marcelovani/arduino-obd2-turbo/sketches/turbo/Settings.h

// Settings.h — Runtime-adjustable parameters and NVS persistence.
//
// cfg* variables are the live trigger/audio values used throughout the sketch.
// CFG_DEFS[] maps each variable to its menu label, edit step, and limits.
// Changes take effect immediately when edited in the menu.
// Saved to NVS on "< Back"; wiped and restored to defaults on "Factory Reset".

enum SettingType { SETTING_FLOAT, SETTING_INT, SETTING_BOOL };

struct SettingDef {
  const char*  label;
  float*       val;
  float        step;  // for BOOL: the "On" threshold value; for others: edit increment
  float        vmin;
  float        vmax;
  SettingType  type;
};

// Initialised from compile-time defaults; changed at runtime via the Settings menu.
float cfgThrottleHigh = TURBO_THROTTLE_HIGH;
float cfgThrottleLow  = TURBO_THROTTLE_LOW;
float cfgRpmMin       = TURBO_RPM_MIN;
float cfgMinGear      = (float)TURBO_MIN_GEAR;
float cfgMaxGear      = (float)TURBO_MAX_GEAR;
float cfgCooldownMs   = (float)TURBO_COOLDOWN_MS;
float cfgVolGear1     = (float)TURBO_VOLUME_GEAR1;
float cfgVolGear2     = (float)TURBO_VOLUME_GEAR2;
float cfgSpeed12      = TURBO_SPEED_GEAR12;
float cfgSpeed23      = TURBO_SPEED_GEAR23;
float cfgVolVoice     = (float)TURBO_VOLUME_VOICE;
float cfgRpmRiseMax   = TURBO_RPM_RISE_MAX;

static SettingDef CFG_DEFS[] = {
  // Turbo trigger conditions (all must be true simultaneously):
  {"Throttle Hi%", &cfgThrottleHigh,   5.0f,  10.0f, 100.0f, SETTING_FLOAT}, // TPS must have been above this (hard push)
  {"Throttle Lo%", &cfgThrottleLow,    1.0f,   0.0f,  50.0f, SETTING_FLOAT}, // TPS must now be below this (lifted off)
  {"RPM Min",      &cfgRpmMin,       100.0f, 500.0f, 6000.0f, SETTING_INT  }, // engine must be spinning above this RPM
  {"Min Gear",     &cfgMinGear,        1.0f,   1.0f,    6.0f, SETTING_INT  }, // only trigger in this gear or higher
  {"Max Gear",     &cfgMaxGear,        1.0f,   1.0f,    6.0f, SETTING_INT  }, // only trigger in this gear or lower
  {"Cooldown ms",  &cfgCooldownMs,   100.0f, 500.0f,10000.0f, SETTING_INT  }, // min time between two triggers (ms)
  // Audio volumes (DFPlayer scale 0–30):
  {"Vol Gear 1",   &cfgVolGear1,       1.0f,   1.0f,   30.0f, SETTING_INT  }, // spray volume for 1st gear change
  {"Vol Gear 2",   &cfgVolGear2,       1.0f,   1.0f,   30.0f, SETTING_INT  }, // spray volume for 2nd gear change
  {"Vol Voice",    &cfgVolVoice,       1.0f,   1.0f,   30.0f, SETTING_INT  }, // voice announcements volume
  // Gear estimation speed bands (km/h — OBD2 PID 010D is always km/h):
  {"Spd G1/G2 km", &cfgSpeed12,        5.0f,   0.0f,  100.0f, SETTING_INT  }, // speed below this = 1st gear
  {"Spd G2/G3 km", &cfgSpeed23,        5.0f,   0.0f,  150.0f, SETTING_INT  }, // speed below this (and ≥ G1/G2) = 2nd gear
  // Free-rev guard — suppresses trigger when RPM jumps fast (clutch in, no load):
  {"Rev Guard",    &cfgRpmRiseMax,   500.0f,   0.0f, 2000.0f, SETTING_BOOL }, // On = 500 RPM/poll threshold; Off = 0
};
#define NUM_CFG_DEFS  (int)(sizeof(CFG_DEFS) / sizeof(CFG_DEFS[0]))

// ── NVS persistence (real device and DEMO builds only) ────────────────────
#ifndef SIMULATION
static void loadSettings() {
  Preferences prefs;
  prefs.begin("turbo", true);
  cfgThrottleHigh = prefs.getFloat("tpsHigh",  cfgThrottleHigh);
  cfgThrottleLow  = prefs.getFloat("tpsLow",   cfgThrottleLow);
  cfgRpmMin       = prefs.getFloat("rpmMin",   cfgRpmMin);
  cfgMinGear      = prefs.getFloat("minGear",  cfgMinGear);
  cfgMaxGear      = prefs.getFloat("maxGear",  cfgMaxGear);
  cfgCooldownMs   = prefs.getFloat("cooldown", cfgCooldownMs);
  cfgVolGear1     = prefs.getFloat("volG1",    cfgVolGear1);
  cfgVolGear2     = prefs.getFloat("volG2",    cfgVolGear2);
  cfgSpeed12      = prefs.getFloat("spd12",    cfgSpeed12);
  cfgSpeed23      = prefs.getFloat("spd23",    cfgSpeed23);
  cfgVolVoice     = prefs.getFloat("volVoice", cfgVolVoice);
  cfgRpmRiseMax   = prefs.getFloat("rpmRise",  cfgRpmRiseMax);
  prefs.end();
}

static void saveSettings() {
  Preferences prefs;
  prefs.begin("turbo", false);
  prefs.putFloat("tpsHigh",  cfgThrottleHigh);
  prefs.putFloat("tpsLow",   cfgThrottleLow);
  prefs.putFloat("rpmMin",   cfgRpmMin);
  prefs.putFloat("minGear",  cfgMinGear);
  prefs.putFloat("maxGear",  cfgMaxGear);
  prefs.putFloat("cooldown", cfgCooldownMs);
  prefs.putFloat("volG1",    cfgVolGear1);
  prefs.putFloat("volG2",    cfgVolGear2);
  prefs.putFloat("spd12",    cfgSpeed12);
  prefs.putFloat("spd23",    cfgSpeed23);
  prefs.putFloat("volVoice", cfgVolVoice);
  prefs.putFloat("rpmRise",  cfgRpmRiseMax);
  prefs.end();
}

static void resetSettings() {
  Preferences prefs;
  prefs.begin("turbo", false);
  prefs.clear();   // wipe the entire "turbo" NVS namespace
  prefs.end();
  cfgThrottleHigh = TURBO_THROTTLE_HIGH;
  cfgThrottleLow  = TURBO_THROTTLE_LOW;
  cfgRpmMin       = TURBO_RPM_MIN;
  cfgMinGear      = (float)TURBO_MIN_GEAR;
  cfgMaxGear      = (float)TURBO_MAX_GEAR;
  cfgCooldownMs   = (float)TURBO_COOLDOWN_MS;
  cfgVolGear1     = (float)TURBO_VOLUME_GEAR1;
  cfgVolGear2     = (float)TURBO_VOLUME_GEAR2;
  cfgSpeed12      = TURBO_SPEED_GEAR12;
  cfgSpeed23      = TURBO_SPEED_GEAR23;
  cfgVolVoice     = (float)TURBO_VOLUME_VOICE;
  cfgRpmRiseMax   = TURBO_RPM_RISE_MAX;
}
#endif
