marcelovani/arduino-obd2-turbo/(commit log)

2026-05-12 Add project plan, README, and CLAUDE.md
    Initial commit for the OBD2 turbo blow-off valve emulator project.
    Covers hardware decisions, BOV trigger algorithm, wiring, build phases,
    and all references from the planning session.
2026-05-12 Update plan with manual gearbox, speaker, and BT audio upgrade
    - CLA180 confirmed manual gearbox; BOV trigger via throttle-drop (no clutch PID needed)
    - Speaker uses DFPlayer Mini built-in 3W amp
    - microSD confirmed available
    - Added Bluetooth A2DP car radio as Phase 6 upgrade option
2026-05-12 Add phase sketches and testing guide
    Phase 1: hardware verification (OLED, IMU, encoder, DFPlayer)
    Phase 2: OBD2 Bluetooth auto-connect + live data
    Phase 3: BOV trigger — plays sound on throttle drop in gears 1-2
    Phase 4: full dashboard — state machine, all sensors, encoder nav
    Each sketch is standalone and buildable independently.
    TESTING.md documents wiring, deploy steps, and expected results per phase.
2026-05-12 Fix Bluetooth PIN, add connection feedback, add no-engine parameters
    - All BT connection code now tries PIN 1234 then 0000 automatically
    - OLED shows which PIN is being tried during connection
    - Connected state shown as filled dot in top-right corner of every screen
    - Phase 2 now reads battery voltage (ATRV), fuel level (012F), and
    coolant temp (0105) — all readable with ignition on, engine off
    - TESTING.md documents all three improvements with troubleshooting tips
2026-05-12 Add test suite, visual monitor, and Makefile
    Unit tests (39 passing):
    - TestParsePid: 13 tests covering speed, RPM, throttle, edge cases
    - TestEstimateGear: 8 tests covering all gears and stopped state
    - TestBovTrigger: 10 tests covering all trigger conditions and cooldown
    - TestScenarios: 7 scenario replays asserting correct BOV counts
    Integration tests:
    - MockElm327Server: in-process TCP ELM327 server with dynamic PID values
    - ElmClient: TCP client matching the ESP32 BluetoothSerial API
    - Tests covering AT init sequence, all PID polling, and end-to-end BOV trigger
    Visual monitor:
    - Terminal OLED simulation with rich library
    - Real-time scenario playback with throttle ba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
2026-05-12 Add Wokwi simulation files (diagram + sketch + libraries)
    Wokwi project in Emulators/Wokwi/ that runs the BOV emulator logic
    in a browser-based circuit simulation without real hardware:
    - diagram.json: ESP32 + SSD1306 OLED + MPU6050 + KY-040 encoder +
    buzzer (DFPlayer placeholder via 1kΩ resistor on GPIO17)
    - sketch.ino: replays a built-in 9s driving scenario that fires two BOV
    triggers (1st→2nd at 2800ms, 2nd→3rd at 5000ms), shows live gauges
    on the simulated OLED, reads real G-force from the MPU6050, and
    lets the encoder cycle views / reset counter
    - libraries.txt: U8g2, Bounce2, Adafruit MPU6050, Adafruit Unified Sensor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
    [sketch.ino]
2026-05-12 Fix Wokwi diagram GND pin names (GND.1/GND.2 → GND)
    wokwi-esp32-devkit-v1 uses esp:GND (not esp:GND.1 / esp:GND.2),
    so the connections were silently ignored and the ESP32 appeared
    unconnected on the canvas.
2026-05-12 Rearrange Wokwi diagram: correct pin names + component positions
    Three fixes combined:
    - Restore GND.1 / GND.2 (correct board.json pin names — my earlier
    change to plain "GND" was wrong and silently dropped all ground wires)
    - Use TX2 instead of D17 (correct board.json name for GPIO17)
    - Reposition components near the pins they connect to:
    OLED + MPU6050 → left of ESP32 (D21/D22 are on left header)
    KY-040 → right of ESP32 (D25/D26/D27 are on right header)
    Buzzer + resistor → left of ESP32 near TX2/D17 level
    Resistor is now horizontal (chain: TX2 → r1:2 → r1:1 → buz:1)
2026-05-12 Add wokwi.toml for VS Code extension
    Points to the Arduino CLI default build output path for the ESP32
    DOIT DevKit V1 board. Compile first with:
    arduino-cli compile --fqbn esp32:esp32:esp32doit-devkit-v1 Emulators/Wokwi/
2026-05-12 Add wokwi-build Makefile target and fix firmware path
    - wokwi-setup: installs arduino-cli board package + libraries (run once)
    - wokwi-build: compiles Emulators/Wokwi/sketch.ino → build/sketch.ino.bin
    - wokwi.toml: firmware path now relative to workspace root, matching
    the arduino-cli --output-dir output
    - .gitignore: exclude Emulators/Wokwi/build/ (compiled artifacts)
    Usage:
    brew install arduino-cli
    make wokwi-setup
    make wokwi-build
2026-05-12 Rename BOV to Turbo; replace Wokwi buzzer with LED indicator
    - Rename all BOV_* constants, bov* variables, checkBov() → Turbo throughout
    all sketches, Python tests, scenarios, and documentation
    - Replace wokwi-buzzer with wokwi-led in diagram.json; LED blinks at ~5 Hz
    for 1 s on each Turbo trigger
    - Add OLED filled-circle indicator (top-right) that mirrors the LED state
    - Rename sketch.ino → Wokwi.ino (arduino-cli requires filename = folder name)
    - Fix wokwi.toml firmware paths to match new binary name
2026-05-12 Remove MPU6050 accelerometer from project
    Not used in trigger logic; removed from Wokwi sketch, diagram, libraries.txt,
    phase4 dashboard, Makefile wokwi-setup, and README hardware table.
2026-05-12 Consolidate into single sketch: sketches/turbo/turbo.ino
    Replace all phase sketches and the separate Wokwi.ino with one unified
    turbo.ino. Simulation vs real-device code is split with #ifdef SIMULATION;
    Makefile passes -DSIMULATION when building for Wokwi. All display logic,
    encoder zone-tracking, and Turbo trigger live in one place.
    - Add sketches/turbo/turbo.ino (unified sketch)
    - Remove Emulators/Wokwi/Wokwi.ino (superseded)
    - Remove sketches/phase1_*, phase2_*, phase3_*, phase4_* (development artefacts)
    - Update Makefile: SKETCH=sketches/turbo, wokwi-build adds -DSIMULATION
    - Update Emulators/Wokwi/wokwi.toml: firmware path → turbo.ino.bin
    - Update README, TESTING.md, CLAUDE.md, tests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
    [turbo.ino]
2026-05-12 Ignore sketches/turbo/build/ arduino-cli output
2026-05-12 Add startup UX and parked screen for real device
    - SCANNING: animated spinner + "Plug ELM327 into OBD2 port" hint
    - CONNECTING: shows device name found before attempting connection
    - INIT_ELM: reads battery voltage immediately after ELM327 init,
    shows "OBD2 connected!" + voltage on confirmation screen
    - RUNNING (engine off, RPM < 200): slow-polls voltage + coolant temp
    every 3s and shows parked screen with blinking "Start engine..."
    - RUNNING (engine on, RPM >= 200): fast-polls TPS/speed/RPM at 10Hz
    and shows the normal gauge views as before
2026-05-12 Simulate all startup stages in Wokwi
    The simulation now mirrors the real device flow:
    SIM_SCANNING (3s) — animated spinner, "Looking for ELM327"
    SIM_CONNECTING (2s) — "Found: ELM327-SIM / Connecting..."
    SIM_INIT (3s) — "Initialising..." then "OBD2 connected!" + battery 12.4V
    SIM_RUNNING — scenario playback
    Scenario extended with 2s engine-off at the start so the parked screen
    (battery + coolant, blinking "Start engine...") is shown before the driving
    begins. drawParked() and showMessage() moved to shared code so both builds
    use the same display logic.
2026-05-12 Play Turbo sound at gear-dependent volume
    Gear 1: volume 30 (100%), gear 2: volume 21 (70%).
    DFPlayer volume is set immediately before play() on each trigger.
2026-05-13 Fix parked-screen flicker during driving
    When an OBD2 poll timed out, parsePID returned -1 and max(0, -1)
    silently set metricRPM=0, triggering the parked screen for one frame.
    Fixed by only updating each metric when the parse result is valid (>=0),
    keeping the last good value on a failed read.
    Also removed duplicate String declaration left by earlier edit.
    [turbo.ino]
2026-05-13 Fix parked screen appearing during driving (two cases)
    Simulation: scenario loop was restarting at index 0 (RPM=0), showing the
    parked screen for 2s on every 11s loop. Now restarts at index 1 (engine
    already at idle, RPM=800) so the loop is seamless.
    Real device: added 3s debounce on the engine-off transition so a transient
    RPM drop (bad poll, brief idle dip) does not immediately flip to the parked
    screen — RPM must stay below ENGINE_IDLE_RPM for 3 consecutive seconds.
    [turbo.ino]
2026-05-13 Fix unresponsive rotary encoder on real device
    Root cause: each obdSend() blocks for up to 1s; the KY-040 CLK pulse
    lasts only ~2ms, so the main loop misses almost every rotation.
    Fix: attach a FALLING-edge interrupt (encISR, IRAM_ATTR) to PIN_ENC_CLK
    so every click is captured immediately into a volatile counter (encDelta).
    readEncoder() atomically drains that counter with noInterrupts/interrupts
    guard each time it runs.
    Also drop STEPS_PER_ZONE from 5 to 1 (1 click = 1 view change) since
    with ISR capture all detents are counted reliably.
    Simulation keeps the original CLK polling (no blocking calls there).
    [turbo.ino]
2026-05-13 Fix encoder ISR debounce (KY-040 contact bounce)
    Previous ISR fired on every bounce pulse; with STEPS_PER_ZONE=1 and
    4 views, bounce accumulating +1/-1 noise often netted to 0 or a multiple
    of 4, making the encoder appear dead.
    Fixes:
    - 4ms debounce in ISR: rejects contact bounce (KY-040 bounce < 3ms)
    - GPIO.in register read instead of digitalRead() — faster and safe in ISR
    - micros() timestamp guards rapid re-entry
    [turbo.ino]
2026-05-13 Fix CCW encoder direction not working
    Root causes:
    1. Single shared 4ms debounce blocked CCW clicks arriving <4ms after a CW
    2. Some KY-040 variants lead with DT not CLK for CCW, so FALLING-CLK ISR
    never fires for CCW at all
    Fix: two independent ISRs with separate 1ms debounce timers:
    encISR_CLK — CLK FALLING while DT=HIGH → one direction (encDelta--)
    encISR_DT — DT FALLING while CLK=HIGH → other direction (encDelta++)
    Both pins attached in setup(). Covers all KY-040 variants, and CW/CCW
    in rapid succession no longer block each other.
    [turbo.ino]
2026-05-13 Fix encoder CCW direction: timing-based ISR replaces pin-state check
    Previous approach read GPIO state inside the ISR to determine direction,
    but on this KY-040 variant both pins change simultaneously for CCW so
    the state check always read the wrong level.
    New approach: whichever pin falls first updates its own timestamp and
    checks whether the other pin's timestamp is stale (>500 µs ago). The
    trailing pin's ISR then skips because it sees a recent cross-pin
    timestamp. This correctly identifies direction without reading pin
    state, and 500 µs self-debounce handles contact bounce.
    [turbo.ino]
2026-05-13 Reduce encoder/display lag: refresh between OBD2 calls, lower timeout
    Each obdSend() was blocking up to 1000ms; 3 calls per poll = up to 3s
    where the encoder and display could not update. Fix: call readEncoder()
    + drawDisplay() between each OBD2 query so the screen stays responsive
    during a poll. Also drop the default obdSend() timeout from 1000ms to
    300ms — on a healthy CAN/BT connection responses arrive in <150ms, and
    the old 1s timeout was the worst-case source of lag.
    [turbo.ino]
2026-05-13 Give encoder priority over OBD2 polling
    When the encoder is turned, OBD2 polling is suspended for 500ms so the
    main loop is free to run readEncoder() + drawDisplay() at full speed.
    The display updates instantly on every detent; OBD2 resumes automatically
    once the user stops interacting with the encoder.
2026-05-13 Three-tier polling: parked / idle / driving based on RPM
    RPM < 200 (parked): poll battery + coolant + RPM every 3s
    RPM < 1000 (idle): poll RPM only every 500ms — rotary fully unblocked
    RPM ≥ 1000 (driving): poll TPS + speed + RPM every 100ms
    No point reading TPS or speed when the car is not moving, and no Turbo
    trigger is possible below 1000 RPM anyway. Removes engineOffSince
    debounce — no longer needed with direct threshold checks.
    [turbo.ino]
2026-05-13 Update docs: three-tier polling, encoder priority, current OBD2 strategy
    - README: rewrite "How it works" to describe parked/idle/driving modes
    - Plan §2: add TURBO_VOLUME_GEAR1/2 thresholds, note driving-mode-only trigger
    - Plan §7: replace single-rate polling table with three-tier strategy,
    add full PID reference and gear ratio table
    - Plan §8: update state machine to show PARKED/IDLE/DRIVING sub-states
    - Plan §9: replace stale timing block with accurate per-mode breakdown
    - Plan §1/§6: remove MPU6050/IMU/G-force (not in the build)
2026-05-13 Update simulation scenario: full 20s cycle with ignition/idle/drive/stop
    0–3s: ignition on, RPM=0 → parked screen
    3–8s: engine idling (RPM 750–850) → idle screen, 5s of rotary freedom
    8–15s: driving 1st/2nd/3rd — Turbo #1 at ~10.3s, Turbo #2 at ~12.5s
    15–20s: stopped/idle → idle screen for 5s
    Loop: restarts from t=0 showing the full cycle each time
2026-05-13 Fix simulation Turbo not triggering
    Two root causes:
    1. checkTurbo() was called every loop frame (~1000x/s in simulation),
    so prevTPS tracked metricTPS almost instantaneously — the condition
    prevTPS>40 AND tps<10 was never simultaneously true. Fixed with a
    100ms rate-limit in simulation, matching the real device poll rate.
    2. Scenario gear-change drops were gradual (over 500ms), so even with
    rate-limiting a check could land mid-drop. Fixed by using 1ms gaps
    for the TPS lift-off events (instantaneous drop in scenario data).
    [turbo.ino]
2026-05-13 Redesign display: two screens using yellow/blue OLED zones
    Screen 0 (bars):
    Yellow header: Turbo:N Gear:N (or PSSSSH! #N on trigger)
    Blue zone: Throttle N% + bar, RPM N + bar, Speed N mph + bar
    Bar scales: throttle=100%, RPM=8000, speed=140mph
    Screen 1 (text only):
    Same yellow header
    Blue zone: Throttle/RPM/Speed as plain text
    Also: encoder now wraps at NUM_VIEWS=2, speed converted to mph
    throughout, drawBar() helper added, 4-dot view indicator removed.
    [turbo.ino]
2026-05-13 Fix Turbo counter, redesign header and scenario
    Turbo was always 0 — root cause: gear thresholds (>110 for 1st) meant
    the scenario's speeds (60+ km/h in 1st) estimated gear 3, failing the
    gear<=2 check. Also the throttle ramped back up too fast after lift-off
    for a 100ms checkpoint to catch prevTPS>40 while TPS<10.
    - Gear thresholds updated: >50=1st, >33=2nd, >19=3rd, >12=4th
    (calibrate from serial monitor for real CLA180, these are defaults)
    - Scenario redesigned: 4 gears per user spec, 200ms TPS hold after each
    lift-off to guarantee a 100ms checkpoint catches the trigger window
    - Header: spaces after "Turbo:" and "Gear:", Gear right-aligned
    - obd_logic.py gear thresholds kept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
    [turbo.ino]
2026-05-13 Update gear thresholds, tests, and add Testing docs
    - Update gear ratio thresholds in obd_logic.py and C++ sketch to match
    higher-speed driving profile (>50 for 1st, >33 for 2nd, etc.)
    - Fix unit test examples and no_turbo_high_gear scenario to use speed
    values that produce ratios in the correct new ranges (39 tests pass)
    - Fix integration test import error: add integration/ dir to sys.path
    so mock_elm327 and elm_client are found (19 tests pass, 58 total)
    - Add Testing section to README with four-layer workflow and table
    - Expand Testing tools section in plan doc with same four-layer table,
    emulator reference, Python mirror note, and gear calibration guide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
2026-05-13 Move initial screen text into blue OLED zone
    All startup/connection/parked screen text was shifted below y=16 so
    nothing renders in the yellow top band. Affected screens:
    - setup() boot splash
    - showMessage() (used for all connection status messages)
    - drawParked() — device name, battery, coolant, 'Start engine...'
    (removed the horizontal divider line that was in the yellow zone)
    - doScanning() inline draw
    - doInitElm() 'OBD2 connected' inline draw
    - Simulation equivalents of scanning, init, and connected screens
    The drawDisplay() driving header at y=11 is unchanged — it is
    intentionally drawn in the yellow zone.
2026-05-13 Restore buzzer in Wokwi sim, keep LED — both trigger on Turbo spray
    - PIN_BUZZER = GPIO17 (TX2): tone(900Hz, 350ms) on every Turbo fire
    - PIN_LED = GPIO2: blinks for 1s after each Turbo fire (visual indicator)
    - diagram.json: wokwi-led+resistor moved to GPIO2; wokwi-buzzer added
    on GPIO17 (TX2), no resistor needed for passive buzzer
    [turbo.ino]
2026-05-13 Fix buzzer wiring: use pin names 1/2 (not +/-)
    wokwi-buzzer exposes pins '1' and '2', not '+'/'-'.
2026-05-13 Move LED from GPIO2 to GPIO4 — GPIO2 is ESP32 built-in LED
    GPIO2 is driven internally by Wokwi for the DevKit's on-board LED,
    which conflicts with the external LED circuit. GPIO4 is a clean GPIO
    with no special role.
2026-05-13 Update docs: Wokwi sim hardware, pin changes, rebuild reminder
    README.md:
    - Add simulated hardware table to Wokwi section (buzzer GPIO17, LED GPIO4)
    - Update Testing section: "OLED, encoder, and DFPlayer" → buzzer + LED
    esp32_obd2_dashboard_plan.md:
    - Testing tools table: add buzzer/LED pins to Wokwi row
    - Code skeleton: add #ifdef SIMULATION pin block (PIN_BUZZER/PIN_LED)
    alongside the real-device DFPlayer pins
    CLAUDE.md:
    - Add Wokwi simulation hardware section (pins, GPIO2 warning)
    - Add "After changing sketch or diagram" rule: make test → make wokwi-build
    → restart simulator; documents that stale firmware causes invisible changes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
2026-05-14 feat: ELM327 bypass, DEMO mode, trigger tuning, debug logging
    Hardware / firmware:
    - Screen initialises first in setup() before BT and DFPlayer
    - DFPlayer plays startup sound to confirm it is working
    - 30-second ELM327 scan timeout → NO_OBD standalone mode (click encoder to retry)
    - Scan screen shows countdown; encoder rotation logged to serial
    - DEMO build mode (-DDEMO): runs built-in driving scenario on real hardware
    using SPI OLED + DFPlayer + encoder, no Bluetooth needed
    - make deploy / make demo-upload / make wokwi-build targets in Makefile
    Trigger tuning:
    - TURBO_THROTTLE_HIGH raised 40 → 60 % (hard acceleration only)
    - TURBO_RPM_MIN raised 1500 → 3000 RPM (near shift point)
    -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
2026-05-14 feat: DFPlayer audio, menu system, demo mode, voice/spray volumes
    Audio:
    - Rename audio/ → mp3/ with 4-digit filenames (0001–0011.mp3)
    - Re-encode all files to MPEG-1 44.1kHz 128kbps CBR mono (DFPlayer requirement)
    - Switch from play() FAT-order to playMp3Folder() filename lookup
    - Add TURBO_VOLUME_VOICE (13) for spoken clips; sprays keep 30/27
    - Add dfplayer_test standalone sketch for audio diagnostics
    turbo.ino:
    - Add menu system (Power / Demo / Settings / Exit) with encoder navigation
    - Add runtime-adjustable trigger settings (TPS%, RPM, gear, cooldown, volume)
    - Rate-limit menu encoder steps to 150ms to prevent bounce skipping
    - Add scanDelay() helper so encoder/menu stays responsiv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
    [turbo.ino]
2026-05-14 fix: try no-PIN and more common ELM327 PINs on connect
    Many cheap ELM327 clones use no PIN, 6789, or 1111 rather than the
    1234/0000 we were trying. Now cycles through five attempts and shows
    the current attempt on the OLED so it is obvious where the handshake
    is getting stuck.
    [turbo.ino]
2026-05-14 feat: switch OBD2 transport from Bluetooth Classic to BLE
    The OBD dongle ("OBD BLE") is a BLE device, not Bluetooth Classic.
    This was confirmed via nRF Connect: PHY LE 1M, service FFF0, notify
    FFF1 (CCCD present), write FFF2. The iOS CarScanner app working with
    it was the key clue — Apple blocks Classic BT for third-party apps,
    so it can only be BLE.
    BluetoothSerial cannot see BLE devices at all; replace with the ESP32
    BLE stack (BLEDevice/BLEClient). Key changes:
    - BLE scan with OBDScanCallbacks — matches on name or FFF0 service UUID
    - 3-second blocking scan bursts; stop() called from callback on match
    - obdSend() writes to FFF2, waits for '>' in notify buffer from FFF1
    - doConnecting(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
    [turbo.ino]
2026-05-14 fix: mute DFPlayer amp between voice announcements to eliminate hiss
    The DFPlayer's onboard amp stays warm when idle, amplifying power-rail
    noise as audible hiss. Fix: play each voice clip, wait for it to
    finish, then call stop()+volume(0) to silence the amp.
    Adds dfplayerVoice(track) helper — plays, waits VOICE_PLAY_MS (3 s),
    then mutes. Applied to every spoken announcement:
    - "Pairing" on scan start
    - "OBD2 not connected" on scan timeout and all connect failures
    - "Goodbye" on power off
    Spray sounds in checkTurbo() are unaffected — they already set their
    own volume before each play, which re-enables the amp as needed.
    Demo mode voice (TRACK_DEMO_MODE) deliberately skips the mu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
    [turbo.ino]
2026-05-14 feat: encoder fix, gear ratios, NVS settings, factory reset
    Encoder (req 1):
    - ISR debounce widened 500 µs → 3000 µs — eliminates jumpy/missed turns
    - Menu step rate limit 150 ms → 50 ms — faster response without skipping
    - obdSend() aborts mid-poll when menu opens so all CPU goes to the UI
    Turbo trigger (req 2):
    - Add TURBO_RATIO_GEAR12=85 / TURBO_RATIO_GEAR23=45 (RPM ÷ km/h) —
    calibrated for CLA180 shifting at ~30 mph (1st→2nd) and ~40 mph (2nd→3rd)
    - estimateGear() uses runtime cfgRatio12 / cfgRatio23 instead of hardcoded values
    - Add clarifying comment: OBD2 PID 010D is always km/h (SAE J1979), even in UK
    Settings (req 3):
    - Expose cfgRatio12, cfgRatio23, cfgVolVoice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
    [turbo.ino]
2026-05-14 feat: improve encoder reliability and responsiveness
    - Replace dual-ISR (CLK+DT) with single ISR on CLK only: reads DT pin
    immediately at CLK falling edge — same algorithm as arduino-laser-target,
    eliminates cross-pin timestamp race and double-counting per detent
    - Remove 50ms menu rate limit in SIMULATION builds: millis() runs at
    simulation speed in Wokwi so a fixed delay feels much longer than intended;
    real hardware keeps the rate limit to guard against ISR accumulation
    - Rename "Factory Rst" → "Factory Reset" in settings menu
    [turbo.ino]
2026-05-14 fix: enable encoder ISR in Wokwi simulation, fix rotation direction
    - ISR (encISR_CLK) and volatile state are now global — no longer guarded
    by #ifndef SIMULATION, so Wokwi captures every CLK edge via interrupt
    instead of polling, fixing the "must click 10 times" problem
    - attachInterrupt() called unconditionally in setup() (both builds)
    - Removed SIMULATION polling path from readEncoder(); both builds now
    consume encDelta from the ISR
    - Swapped encDelta++ / encDelta-- to fix reversed rotation direction
    - Removed redundant lastClk variable (only needed for polling)
    - Removed extra readEncoder() calls after menu draws (no longer needed
    with ISR-driven input)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
    [turbo.ino]
2026-05-14 refactor: split monolithic sketch into 11 dedicated modules
    Each responsibility now lives in its own .h file (Config, Settings,
    GearEstimator, Audio, Display, Menu, Encoder, TurboTrigger, Scenario,
    SimLoop, OBD2). turbo.ino is reduced to shared state, includes, setup()
    and loop(). All 82 unit + integration tests pass, Wokwi build confirmed.
2026-05-14 feat: OBD2 recorder, WiFi export, delete, huge_app partition
    - Recorder.h: records TPS/RPM/speed/voltage/coolant to LittleFS every
    100 ms as log_NNN.csv; sequential filenames persisted in NVS
    - WifiExport.h: WiFi AP (TurboESP32 / turbo1234) + HTTP server at
    192.168.4.1 — list, download, and delete log files in the browser
    - Menu: adds Record and Export items (real/DEMO builds only); scrollable
    6-item main menu; dedicated full-screen recording view with blinking
    * REC indicator and live RPM/TPS readout
    - Export mode pauses OBD2 state machine to avoid BLE+WiFi radio conflict
    - Partition scheme: deploy and demo-upload now use huge_app (3 MB app +
    896 KB LittleFS) — required becaus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
    [Encoder.h, Menu.h, OBD2.h, Recorder.h, SimLoop.h, WifiExport.h, turbo.ino]
2026-05-14 feat: factory reset wipes settings and all log files
    wipeAllLogs() deletes every log_NNN.csv from LittleFS and resets the
    NVS file counter to 0. Called alongside resetSettings() in the Settings
    > Factory Reset path. OLED confirms "Settings + logs / cleared."
    [Menu.h, Recorder.h]
2026-05-14 refactor: record only ms/tps/rpm/speed; enforce standby-only battery+coolant
    - Recorder.h: CSV trimmed to 4 columns (ms, tps, rpm, speed) — removes
    voltage and coolant which are only meaningful on the standby screen
    - OBD2.h: comment made explicit — battery (ATRV) and coolant (0105) are
    NEVER polled outside the engine-off / standby block
    - README: CSV format updated to match; note added clarifying standby-only policy
2026-05-14 fix: speed-band gear estimation, relative TPS PID, tunable speed thresholds
    Replace ratio-based gear estimation (RPM ÷ speed) with a speed-band approach:
    gear drops naturally as speed drops, eliminating stickiness when clutch is
    depressed mid-pull. Gear 1/2 boundary at 50 km/h (30 mph), 2/3 at 65 km/h
    (40 mph) per CLA180 real shift points; tunable down to 0 via Settings menu.
    Switch TPS polling from PID 0x11 (Absolute Throttle Position, ~10% at idle)
    to PID 0x45 (Relative Throttle Position, 0% at closed throttle). Fixes the
    always-showing-10% issue when not touching the throttle.
    [Config.h, GearEstimator.h, OBD2.h, Scenario.h, Settings.h]
2026-05-14 docs: update plan with current implementation status and gear detection research
    Add §14 (current implementation status, sketch modules, build modes, resolved
    issues) and §15 (gear detection research: why no OBD2 PID exists for clutch
    or manual gear position on CLA180, speed-band approach rationale, Engine Load
    heuristic and CAN sniffer as future options, all research links included).
2026-05-14 docs: new gear detection plan; fix: halve BLE scan timeout to 30 s
    Move current implementation status and gear detection research into a
    dedicated gear_detection_plan.md. Update esp32_obd2_dashboard_plan.md §14
    to reference the new file instead of duplicating content.
    Reduce SCAN_TIMEOUT_MS from 60 s to 30 s so the device reaches the
    "No OBD2 / Display only" screen faster when used without the car.
    [OBD2.h]
2026-05-14 fix: OBD2 polling now continues during recording; skip idle rows in recorder
    obdSend() was bailing out for any non-MENU_CLOSED state, including
    MENU_RECORDING, leaving all metrics stale throughout a recording session.
    Fixed by allowing polling to continue when on the recording screen.
    Also skip writing rows while below ENGINE_DRIVING_RPM to avoid logging
    stale zeros from the idle poll period.
    Added recordings/ to .gitignore.
    [OBD2.h, Recorder.h]
2026-05-14 docs: add mph equivalents to gear speed threshold comments
2026-05-15 feat: embed runtime settings in CSV header for accurate viewer trigger detection
    Recorder.h now writes active cfg* values as a # comment line at the top
    of each recording. The viewer reads those values and uses them for trigger
    detection instead of hardcoded defaults, so the yellow spray lines always
    reflect what the device actually did during that drive. Falls back to
    default constants for old recordings without a header. Settings source
    (csv vs defaults) shown in the stats bar. Also fixes make viewer via
    allow_reuse_address on the HTTP server.
    [Recorder.h]
2026-05-15 feat: run viewer in background with make viewer / make stop-viewer
    make viewer now starts server.py in the background and saves the PID
    to /tmp/turbo_viewer.pid. Running it again when already running prints
    the existing PID instead of starting a second instance. make stop-viewer
    kills the process and cleans up the PID file.
2026-05-15 refactor: move shared trigger logic to lib/turbo_logic.py
    Single Python source of truth for parse_pid(), estimate_gear(), and
    TurboTrigger — shared by tests/ and viewer/ so both stay in sync
    with Config.h constants automatically.
2026-05-15 docs: add per-folder READMEs and simplify main README with links
    Each folder now has its own README covering what it contains and how to use it.
    Main README trimmed to intro, hardware, trigger logic, folder guide, and images.
    Also updated .gitignore to track recordings/README.md while still ignoring CSVs.
2026-05-15 chore: add sample recording log_001.csv for viewer demo
    [log_001.csv]
2026-05-15 refactor: rename Emulators→emulators and Wokwi→wokwi, update all references
2026-05-15 feat: Rev Guard (free-rev suppression) + SettingType enum refactor
    Adds an optional RPM-rise-rate guard to suppress false Turbo triggers
    when the clutch is depressed and the engine free-revs (no load). Off by
    default (cfgRpmRiseMax = 0); enabled via Settings → Rev Guard (On/Off).
    Also replaces the dual isInt/isBool boolean flags in SettingDef with a
    clean SettingType enum (SETTING_FLOAT, SETTING_INT, SETTING_BOOL), and
    renames TPS High/Low labels to Throttle Hi%/Lo%.
    [Config.h, Encoder.h, Menu.h, Settings.h, TurboTrigger.h, turbo.ino]
2026-05-18 feat: add 0012.mp3 as default spray for all gear changes
    Adds a new spray sound (0012.mp3, 1.185 s, 44100 Hz mono 128k CBR) as
    the single default track played on every Turbo trigger regardless of
    gear. Existing 0010/0011 are kept on the SD card as named alternatives.
    - Config.h: TRACK_SPRAY_DEFAULT = 12; GEAR1/GEAR2/GEAR3 all point to 12
    - TurboTrigger.h: simplified to always play TRACK_SPRAY_DEFAULT
    - viewer/server.py: spray duration updated to 1.185 s for all gears
    - mp3/README.md: table updated to reflect new default
2026-05-18 feat: switch spray sound to WAV (0012.wav) for reliable DFPlayer playback
    MP3 frame timing caused ~17% slow playback on the DFPlayer clone.
    WAV (PCM 16-bit, 44100 Hz, mono) has no frame headers to misread.
    playMp3Folder() plays files from /mp3/ by number regardless of extension,
    so no functional code change is needed — only the file format changes.
    - mp3/0012.mp3 → mp3/0012.wav (pcm_s16le 44100 Hz mono, 1.228 s)
    - viewer/server.py: spray duration updated to 1.228 s
    - Config.h: comment updated to reference 0012.wav
    - mp3/README.md: table updated to .wav extension
2026-05-18 fix: re-encode 0012.wav at 22050 Hz for DFPlayer clone
    Clone ignores WAV sample rate header and plays at a fixed 22050 Hz,
    causing 44100 Hz files to play at half speed.
2026-05-18 revert: switch back to 0012.mp3 (WAV approach did not fix slow playback)
    Reverts c8aa43d and 035e0ef. WAV at both 44100 Hz and 22050 Hz still
    played at incorrect speed on the DFPlayer clone.
    [Config.h]
2026-05-18 fix: move spray to track 5 (0005.mp3) — track 12 plays slow on this DFPlayer clone
    Some DFPlayer clones have a bug where track numbers ≥ 10 play at the wrong
    speed. Track 1 played the same audio correctly; using track 5 avoids the issue.
    [Config.h]
2026-05-18 fix: lower default volumes to prevent DFPlayer clock slowdown
    DFPlayer clone oscillator droops at high amplifier load (vol 30), causing
    slow playback. Defaults: spray vol 13, voice vol 10. Menu allows 1–30.
    [Config.h, Settings.h]
2026-05-19 docs: add perfboard wiring diagram SVG
    Shows all component connections: ESP32, DFPlayer Mini, OLED SSD1306 SPI,
    KY-040 encoder, and speaker. Color-coded by signal type.
2026-05-19 fix: use distinct colours for encoder CLK, DT, SW wires
    CLK: dark green (#2E7D32), DT: amber (#F9A825), SW: teal (#00838F).
    Previous three shades of green were hard to tell apart.
2026-05-19 fix: change GPIO23 (MOSI) wire to yellow (#FFD600)
2026-05-19 fix: change GPIO15 (RES) wire to green (#00C853)
